Chirag-0412/Three-Band-Audio-Preamplifier/Figures/Output Stage.png

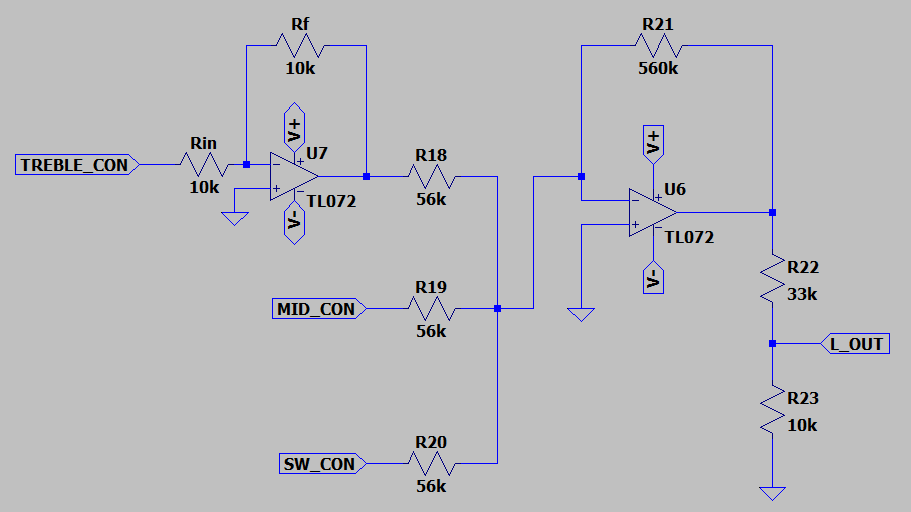
Figures/Output Stage.png
