Chirag-0412/Three-Band-Audio-Preamplifier/LTSpice-Sim/Audio-Preamplifier.asc

C1: cap; 1.6n
C2: cap; 22n
C3: cap; 680p
C4: cap; 680p
C5: cap; 150p
C6: cap; 150p
C7: cap; 90p
C8: cap; 90p
R1: res; 100k
R2: res; 39k
R3: res; 470k
R4: res; 780k
R5: res; 100k
R6: res; 56k
R7: res; 780k
R8: res; 5.6k
R9: res; 10k
R10: res; 270k
R11: res; 270k
R12: res; 100k
R13: res; 56k
R14: res; 270k
R15: res; 100k
R16: res; 56k
R17: res; 270k
R18: res; 56k
R19: res; 56k
R20: res; 56k
R21: res; 560k
R22: res; 33k
R23: res; 10k
Rf: res; 10k
Rin: res; 10k
S1: sw; SWMOD
S2: sw; SWMOD
U1: opamp2; TL072
U2: opamp2; TL072
U3: opamp2; TL072
U4: opamp2; TL072
U5: opamp2; TL072
U6: opamp2; TL072
U7: opamp2; TL072
V1: voltage; 12
V2: voltage; 12
V3: signal; AC 1 0
V4: voltage; 5
X1: potentiometer; R=10k slider=50
X2: potentiometer; R=10k slider=50
X3: potentiometer; R=10k slider=50
X4: master_volume; R=100k slider=100
Named nets: 0, V+, V-, in-L, BASS, MID, TREBLE, SW_CON, MID_CON, TREBLE_CON, L_OUT, MASTER_OUT, COM, Vctrl
.inc TL072.LIB
.ac dec 100 10 10k
Stage-A
Stage-B
.model SWMOD SW(Ron=1 Roff=1Meg Vt=2.5 Vh=0.1)
Buffer Stage
Bass Stage
Midrange Stage
Treble Stage
Output Stage
EQ/Bypass stage
Master Volume
