Chirag-0412/Three-Band-Audio-Preamplifier/LTSpice-Sim/potentiometer.asc

R1: res; {Ra}
R2: res; {Rb}
Named nets: 1, 2, 3
.param Ra=R*(1-(slider/100))+1E-6
.param Rb=R*(slider/100)+1E-6
.param R=10k slider=50
