Chirag-0412/Three-Band-Audio-Preamplifier/(commit log)

2026-09-12 Add README for three-band audio preamplifier project
    Added detailed project description, design targets, signal flow, repo structure, simulation instructions, tools used, and references.
2026-09-12 Revise README for improved clarity and detail
    Updated project description for clarity and detail, including design targets and signal flow.
